T3le/otgw/rev1/Outputs/3D/OTGW-rev1-WiFi-DIP.PNG

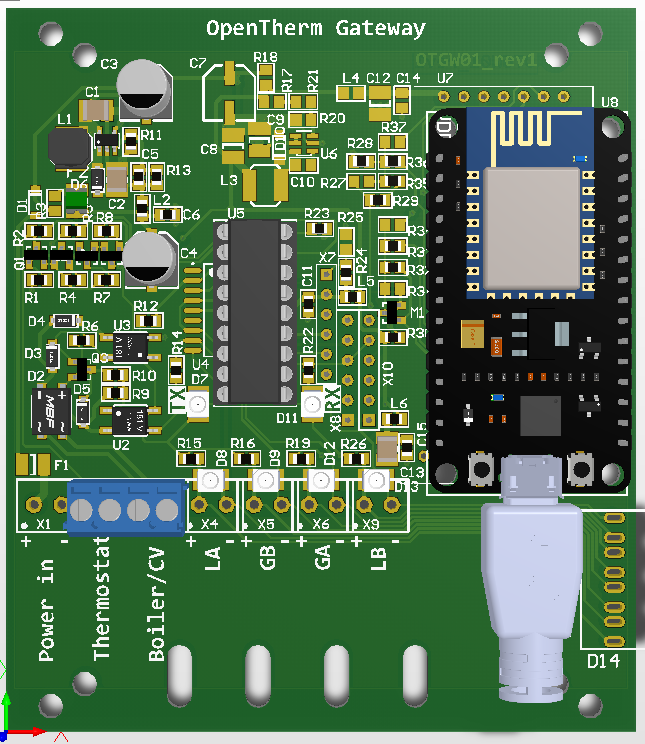
rev1/Outputs/3D/OTGW-rev1-WiFi-DIP.PNG
