T3le/otgw/rev1/Outputs/3D/OTGW-rev1-WiFi.PNG

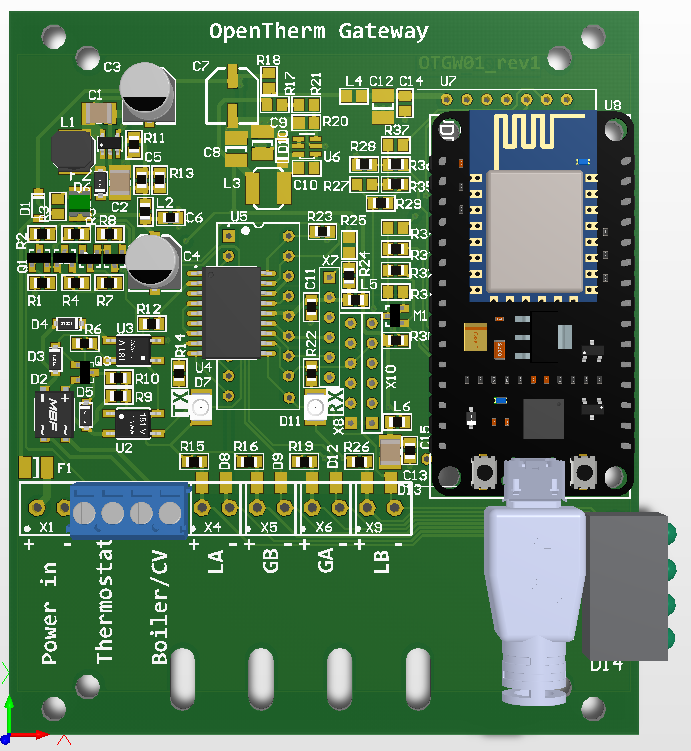
rev1/Outputs/3D/OTGW-rev1-WiFi.PNG
