T3le/otgw/README.md

# otgw

Please see http://gathering.tweakers.net/forum/list_message/47055367#47055367
