T3le/otgw/rev1/Outputs/3D/OTGW-rev1-Ethernet.PNG

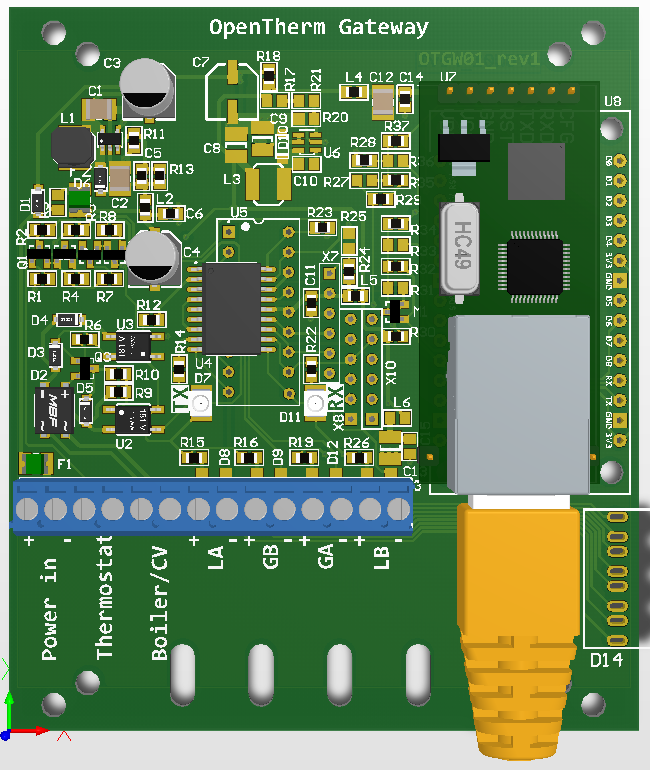
rev1/Outputs/3D/OTGW-rev1-Ethernet.PNG
