T3le/otgw/rev1/Outputs/Schematics/OTGW01_rev1-Eth-ext_5V-desk-soic.PDF

Optional TxD/RxD 5v <-> 3v3 level translator

FTDI cable debug headers

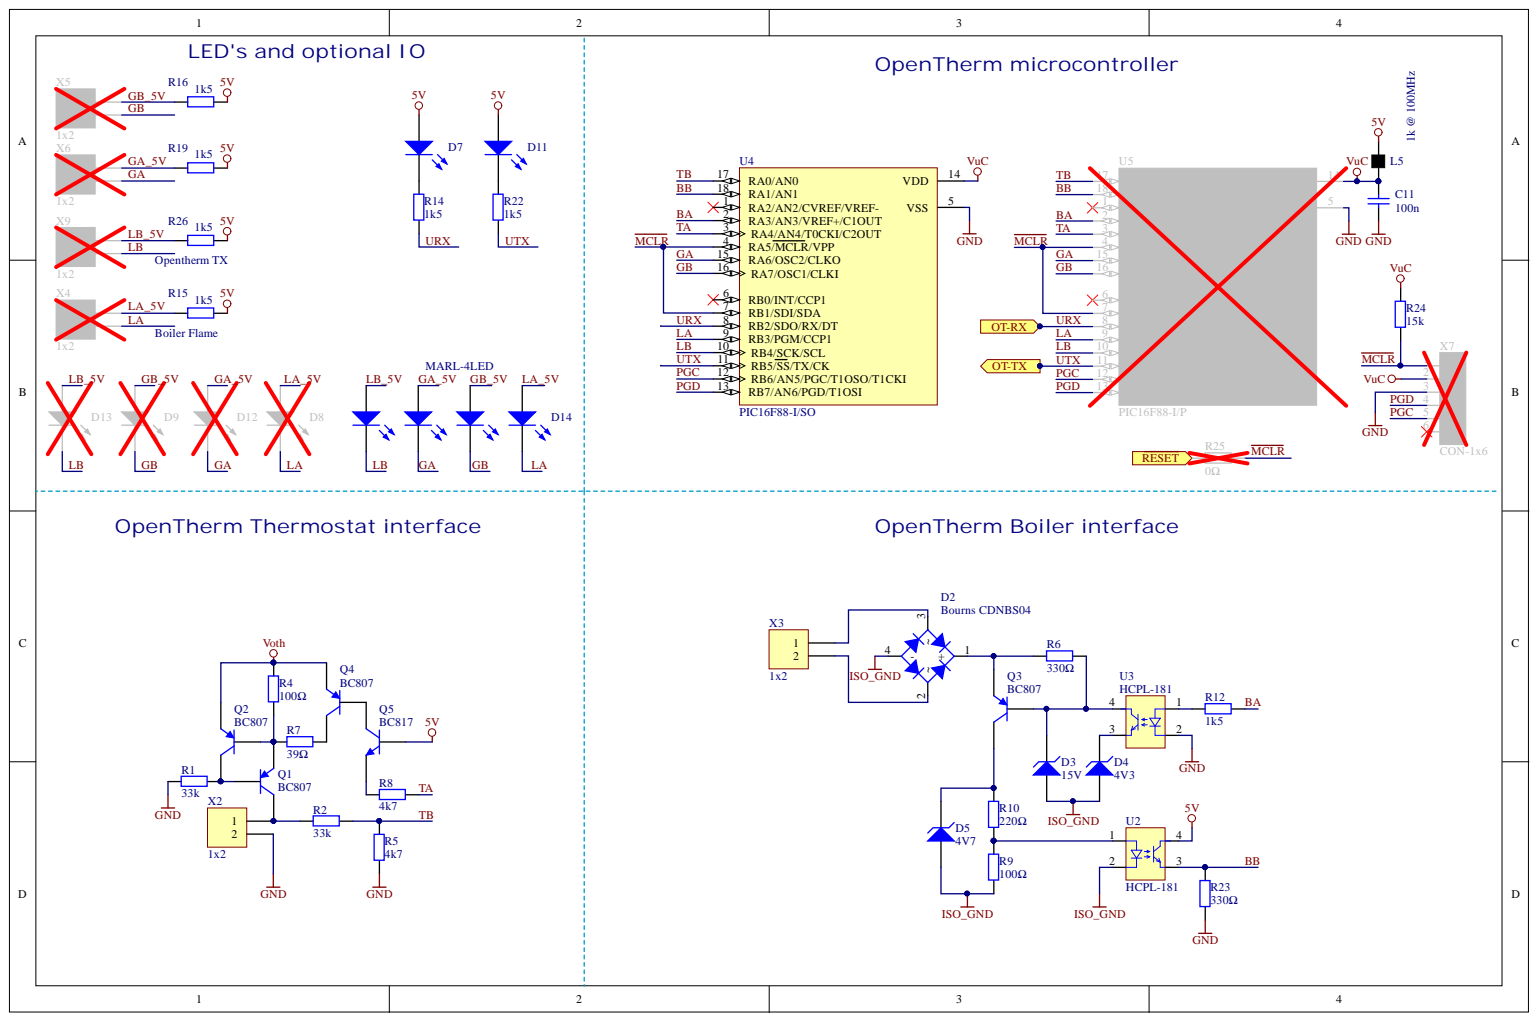
[picture p14: page 3]

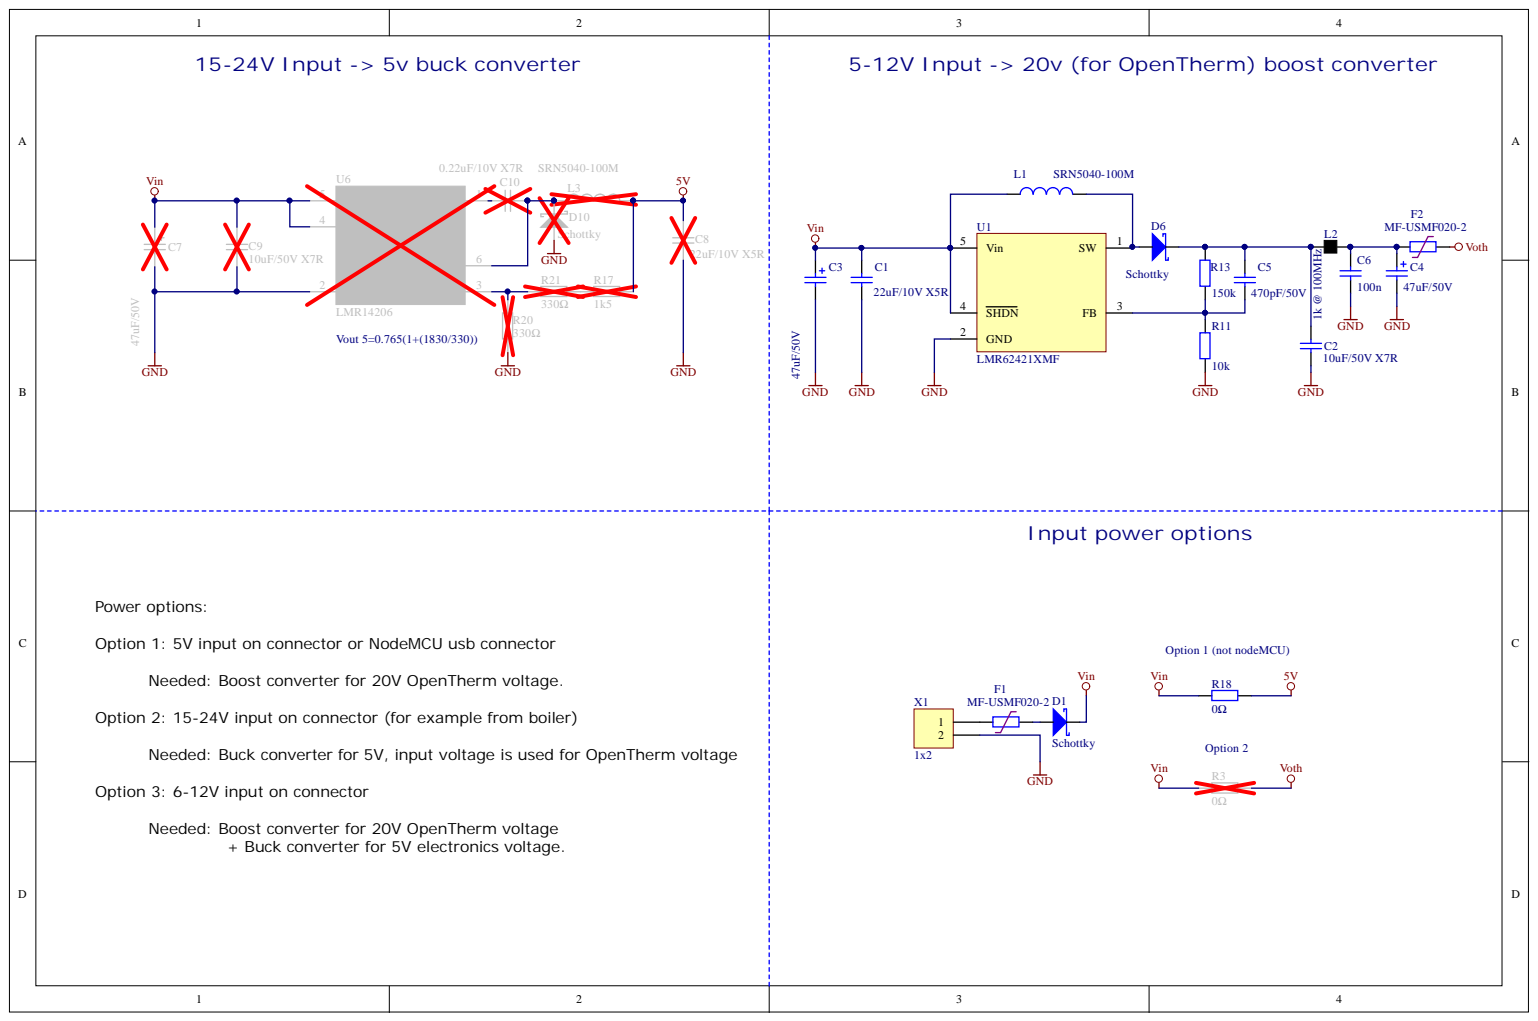
[picture p15: page 4]

Option 1: 5V input on connector or NodeMCU usb connector

Needed: Boost converter for 20V OpenTherm voltage.

Option 2: 15-24V input on connector (for example from boiler)

Needed: Buck converter for 5V, input voltage is used for OpenTherm voltage

Option 3: 6-12V input on connector

Needed: Boost converter for 20V OpenTherm voltage

+ Buck converter for 5V electronics voltage.
