T3le/otgw/rev1/Outputs/Variants/OTGW01_rev1-Eth-ext_15-20V-desk-soic-boardled.PDF

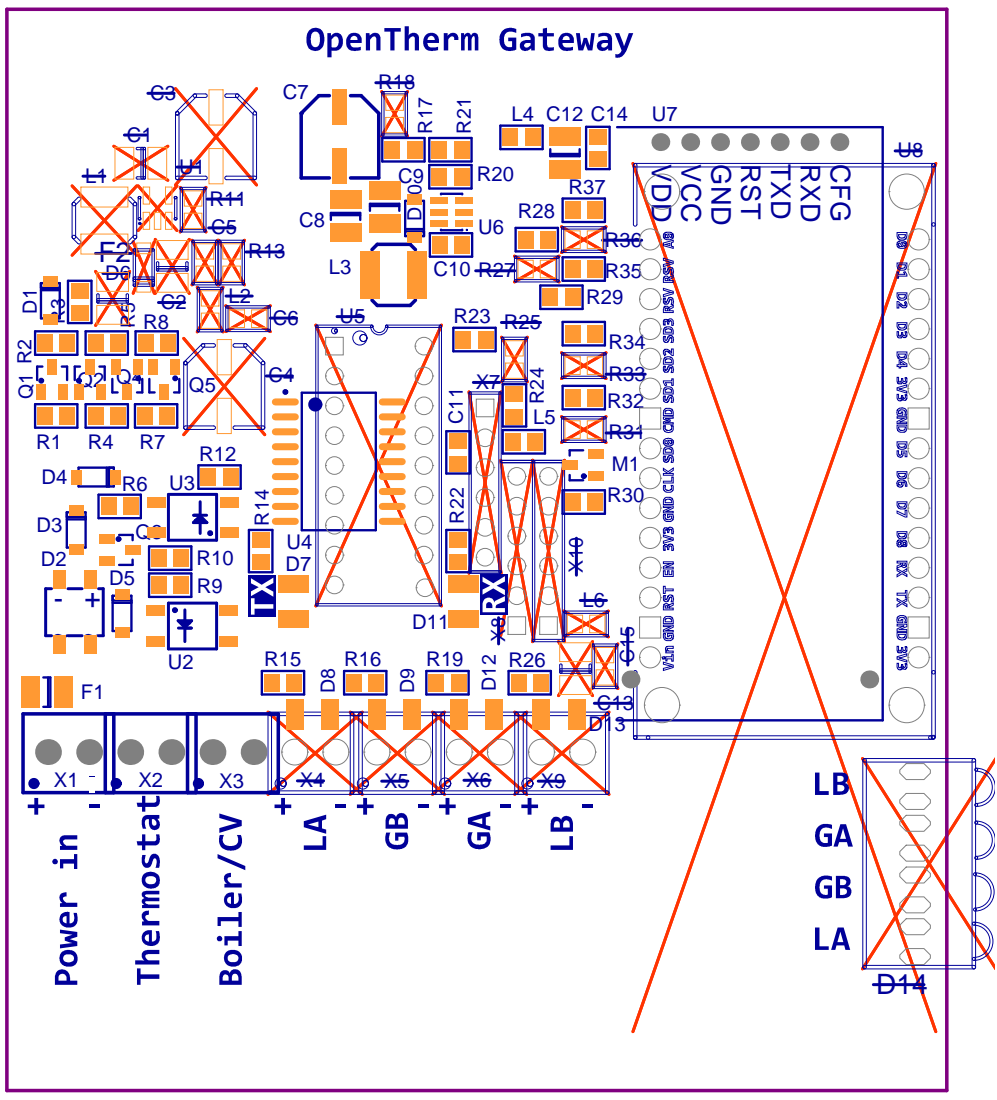
[picture p25: page 1]
