T3le/otgw/rev1/Outputs/Variants/OTGW01_rev1-Eth-ext_5V-desk-soic.PDF

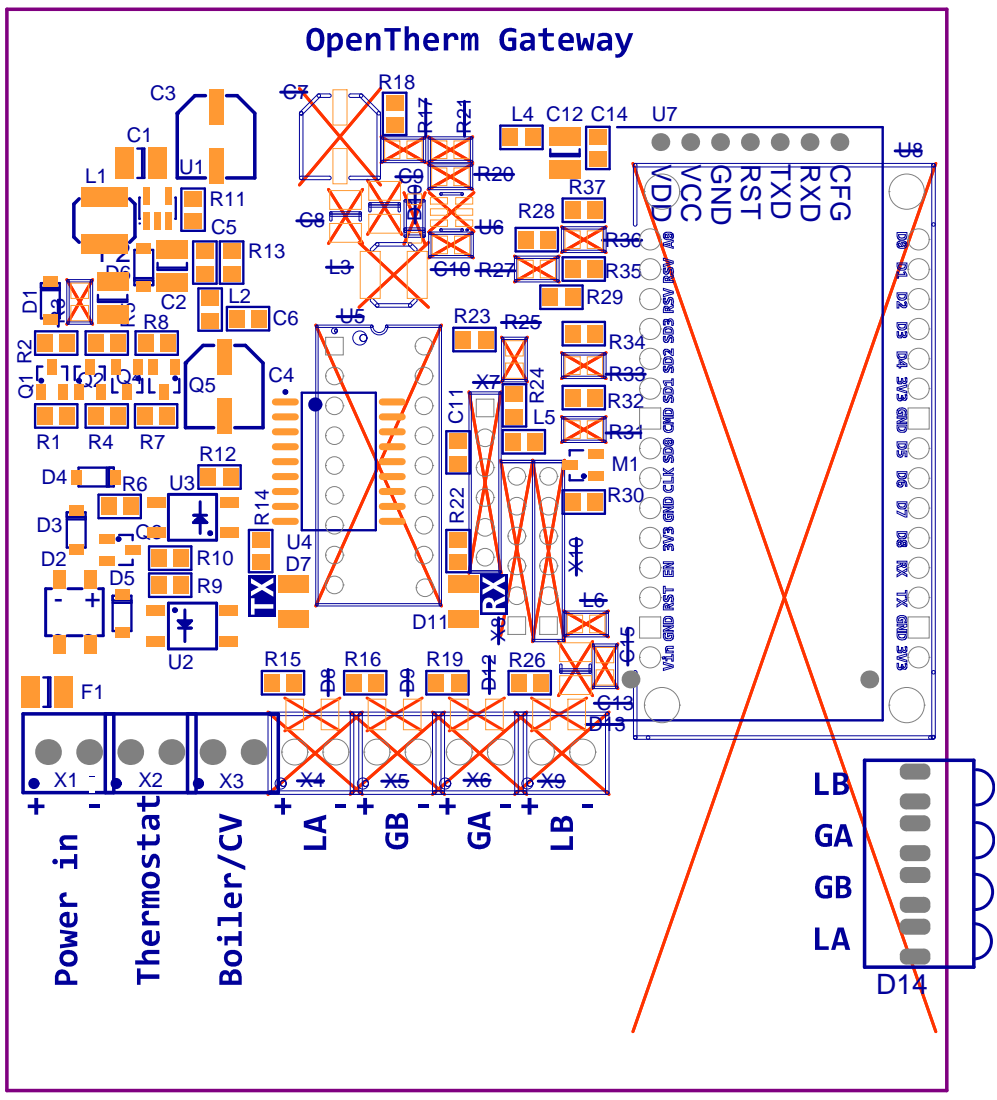
[picture p26: page 1]
