T3le/otgw/rev1/Outputs/Variants/OTGW01_rev1-Eth-ext_5V-wall-soic-extled.PDF

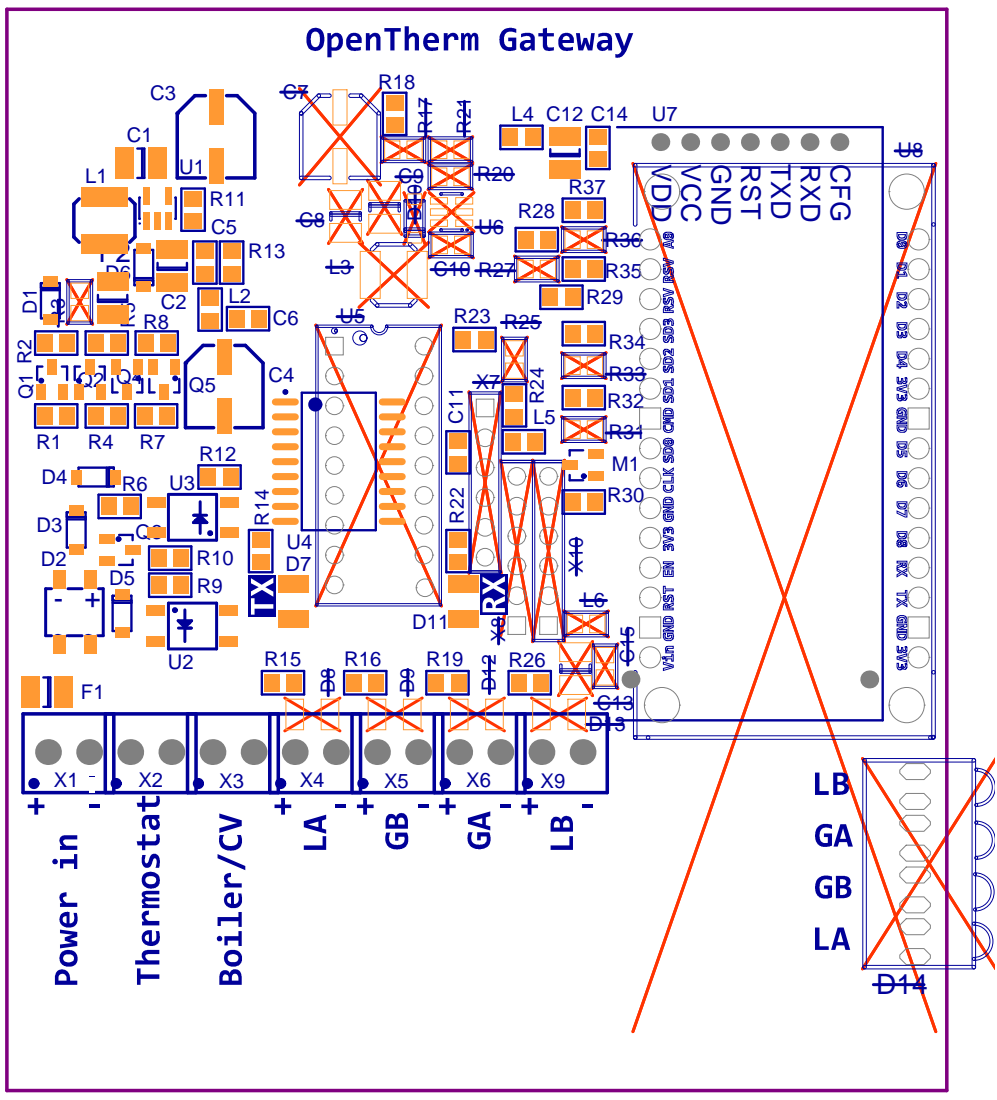
[picture p27: page 1]
