T3le/otgw/rev1/Outputs/Variants/OTGW01_rev1-WiFi-usbpower-desk-soic.PDF

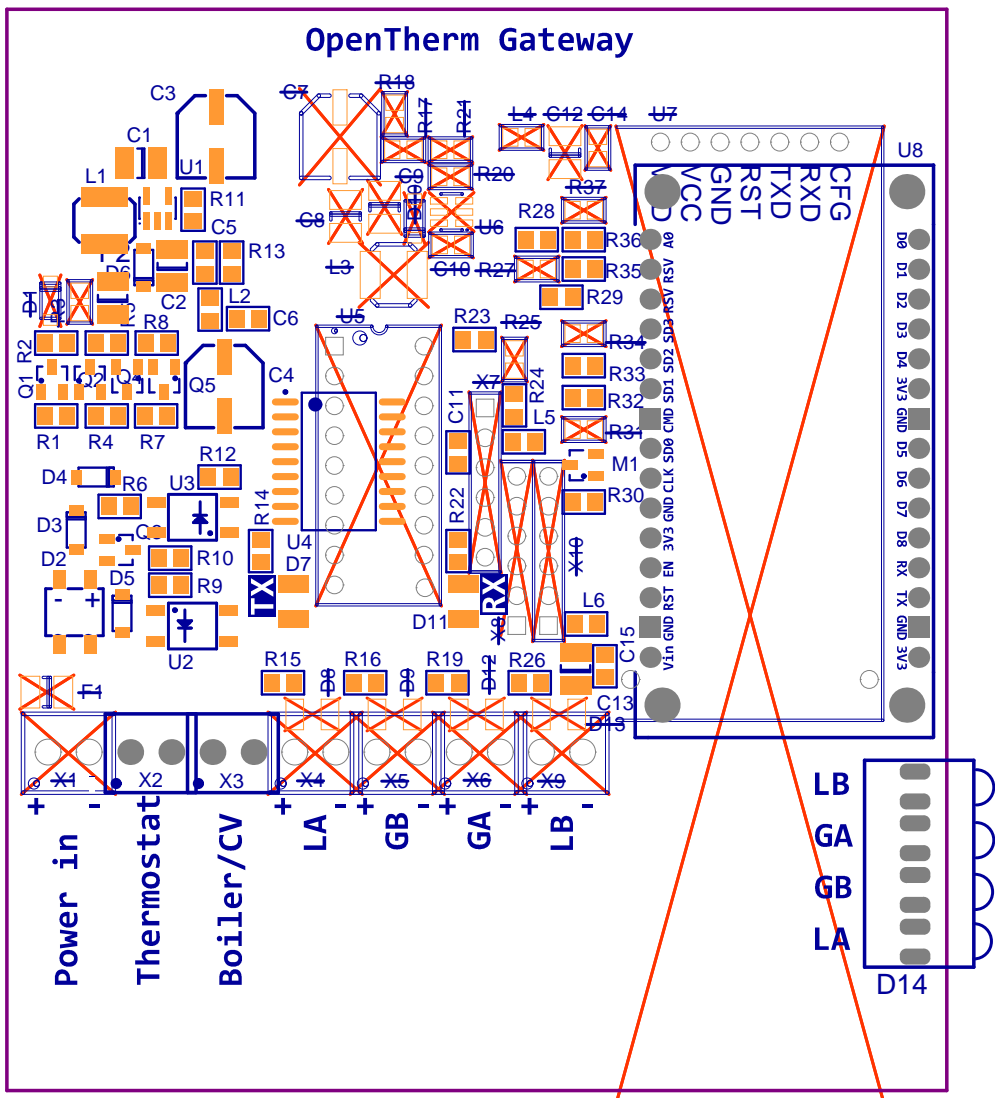
[picture p28: page 1]
