T3le/otgw/rev1/Outputs/Variants/OTGW01_rev1-WiFi-usbpower-wall-dip-boardled.PDF

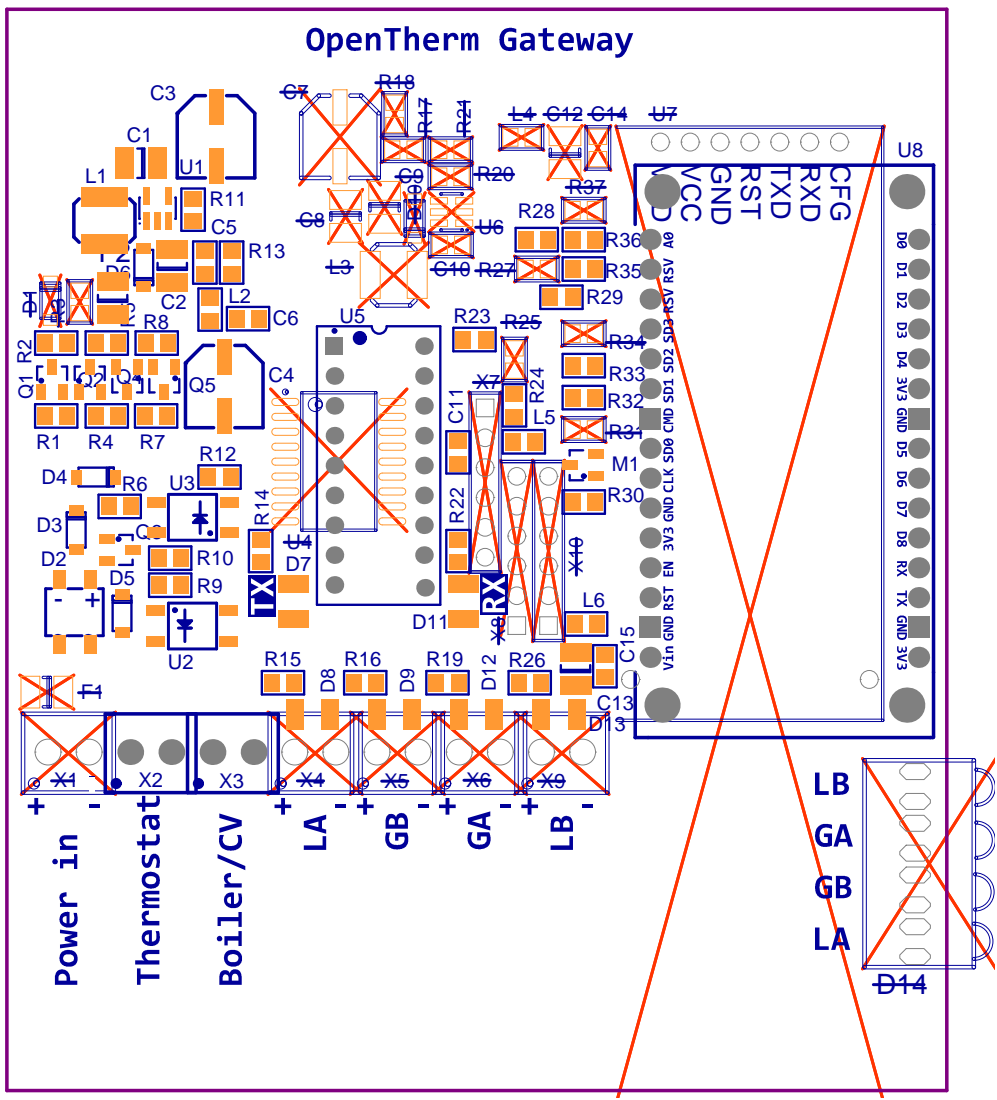
[picture p29: page 1]
