T3le/otgw/(list of files, drawings)

Other design files:
rev1/OTGW01_interfaces_rev1.SchDoc
rev1/OTGW01_opentherm_rev1.SchDoc
rev1/OTGW01_psu_rev1.SchDoc
rev1/OTGW01_rev1.PrjPCB
rev1/OTGW01_rev1.SchDoc
rev1/OTGW01_rev1.SchLib
