T3le/otgw/(commit log)

2016-05-30 OpenTherm Gateway rev1
    First commit of OTGW-rev1
    [OTGW01_rev1-Eth-ext_15-20V-desk-soic-boardled.csv, OTGW01_rev1-Eth-ext_5V-desk-soic.csv, OTGW01_rev1-Eth-ext_5V-wall-soic-extled.csv, OTGW01_rev1-WiFi-usbpower-desk-soic.csv, OTGW01_rev1-WiFi-usbpower-wall-dip-boardled.csv]
2016-06-01 OTGW_rev1 first complete commit
    [OTGW01_interfaces_rev1.SchDoc, OTGW01_opentherm_rev1.SchDoc, OTGW01_psu_rev1.SchDoc, OTGW01_rev1-Eth-ext_15-20V-desk-soic-boardled.csv, OTGW01_rev1-Eth-ext_5V-desk-soic.csv, OTGW01_rev1-Eth-ext_5V-wall-soic-extled.csv, OTGW01_rev1-WiFi-usbpower-desk-soic.csv, OTGW01_rev1-WiFi-usbpower-wall-dip-boardled.csv]
